DeMarco/DMH-Submodules/README.md

# DMH-Submodules
Collection of small plugin PCBs used as subcircuits in major Kosmo modules
