DeMarco/DMH-Submodules/DMH_Submodule_XFader/DMH_Submodule_XFader.kicad_pcb

## KiCad design DMH_Submodule_XFader/DMH_Submodule_XFader.kicad_pcb (2026-10-17)

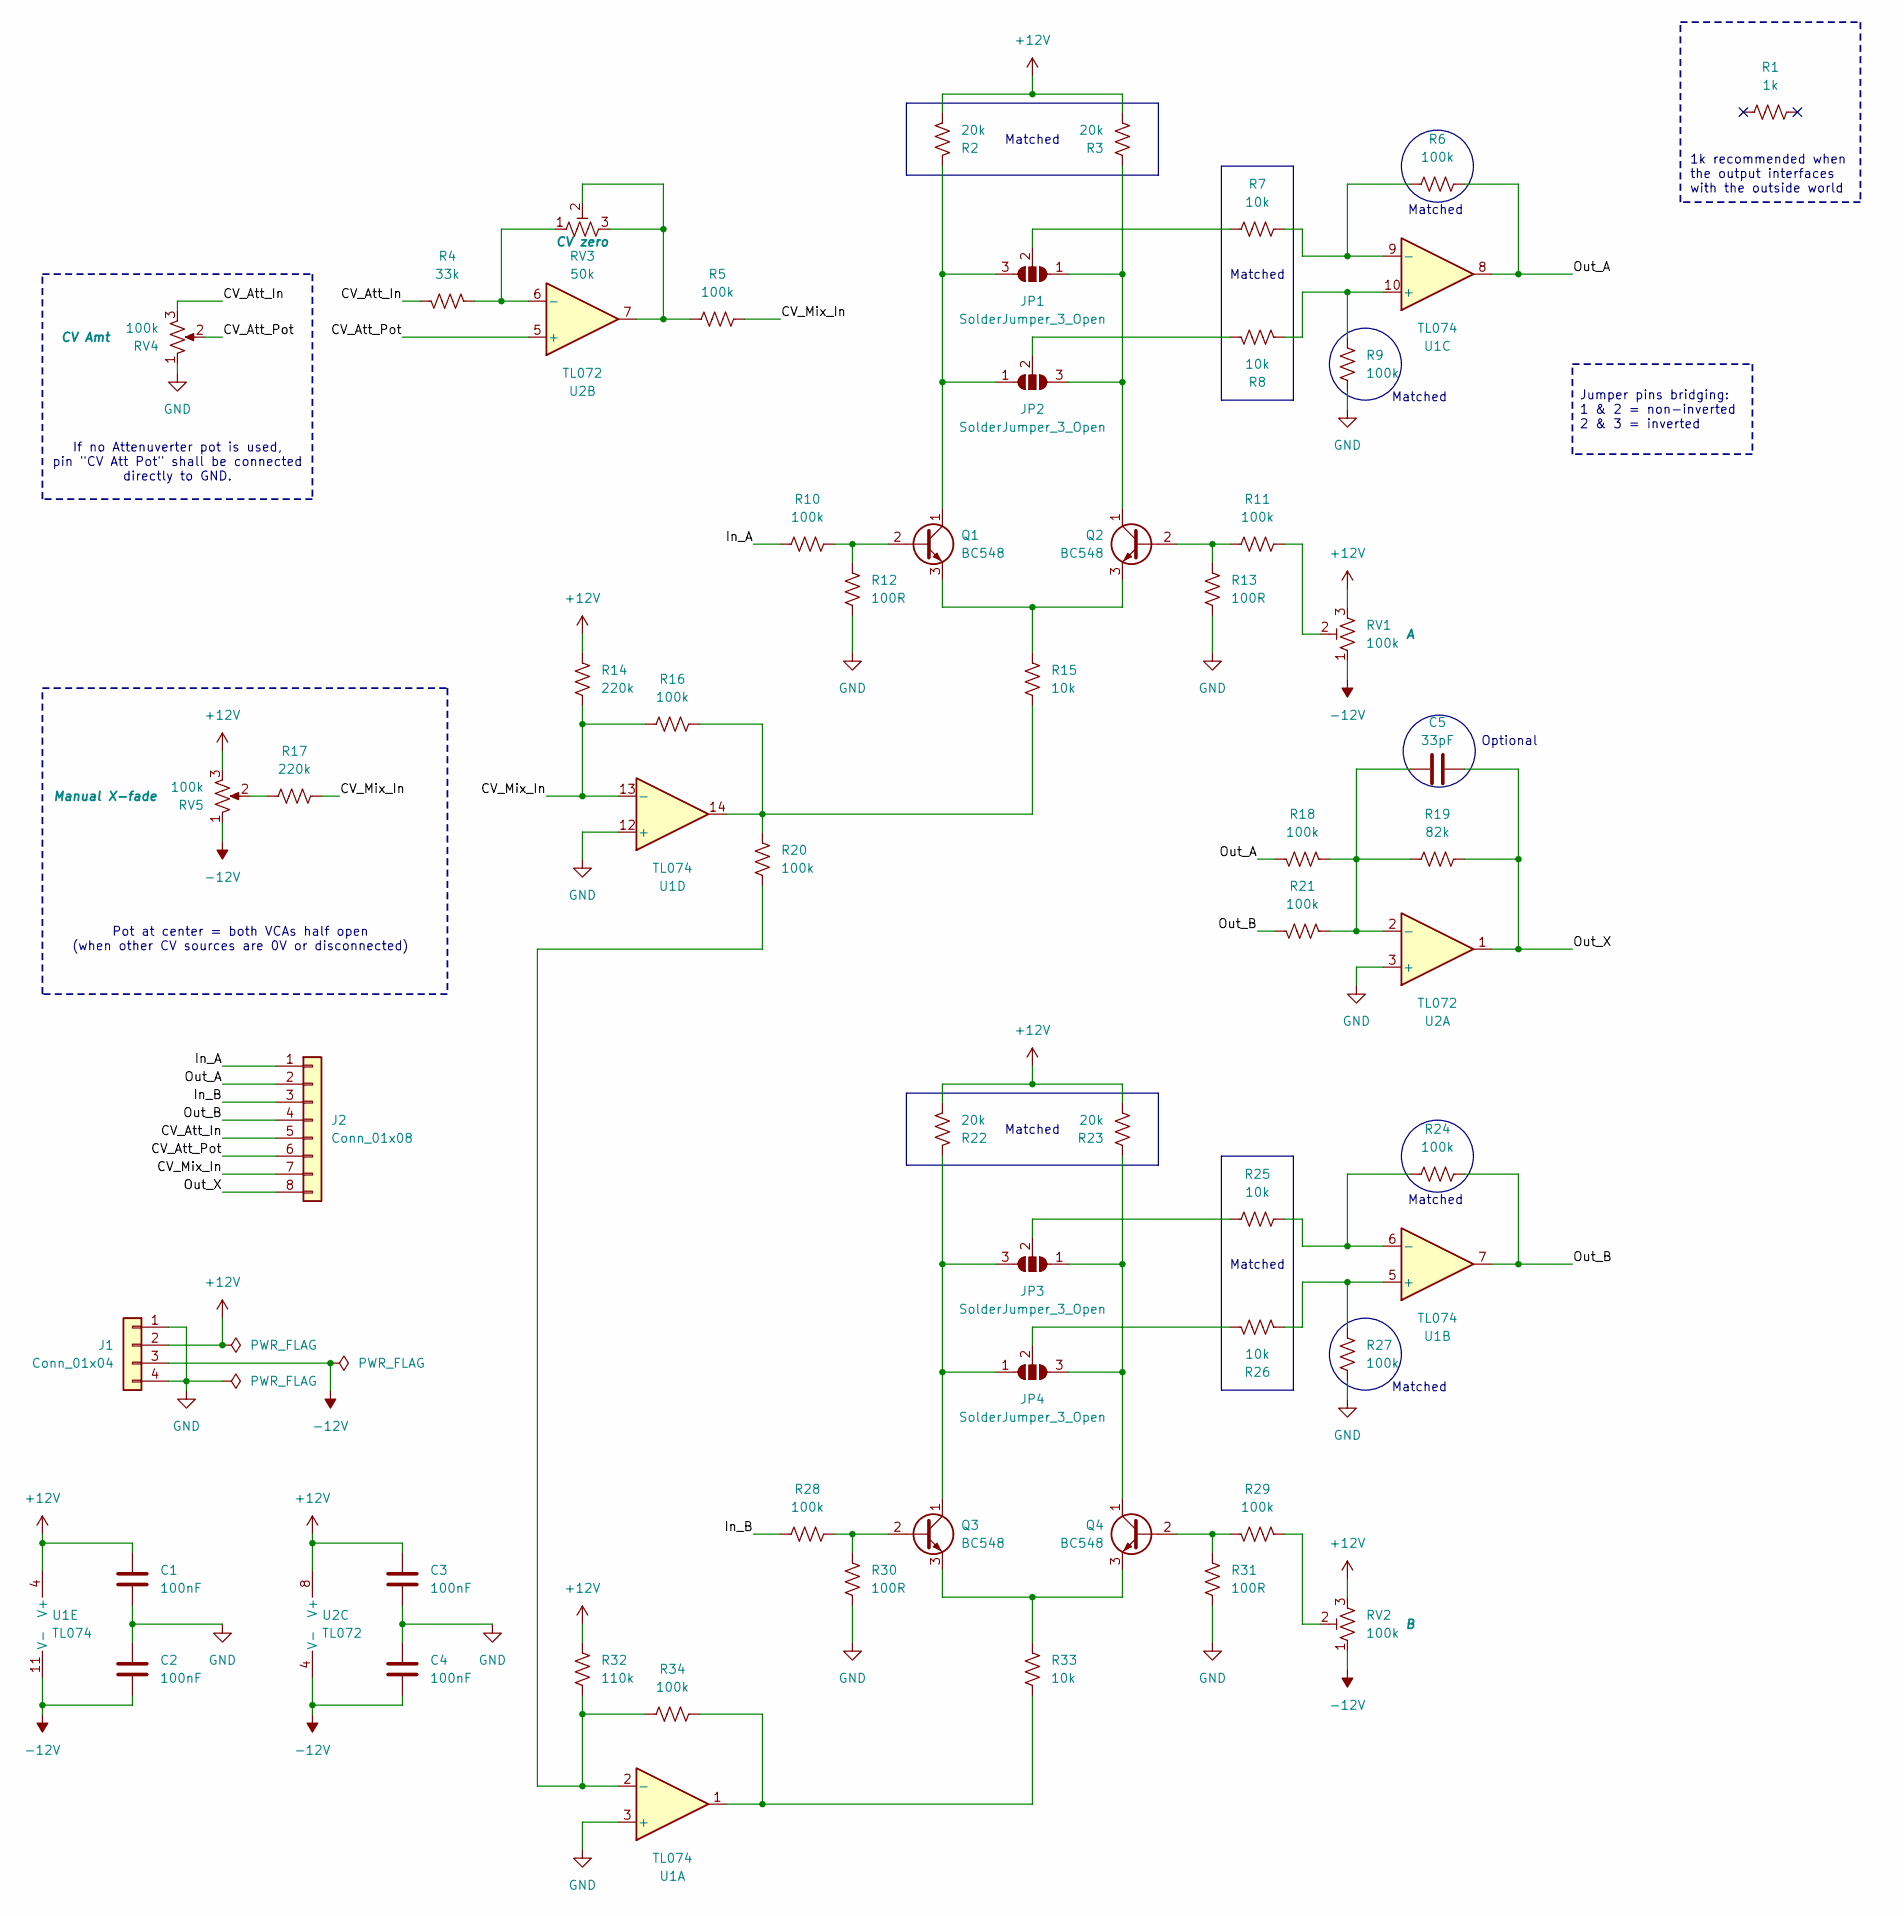
[picture p1: schematic DMH_Submodule_XFader.kicad_sch, Cross Fader Submodule]

Parts:
C1, C2, C3, C4: 100nF; C_Disc_D4.3mm_W1.9mm_P5.00mm
C5: 33pF; C_Disc_D3.0mm_W2.0mm_P2.50mm
J1: Conn_01x04; PinHeader_1x04_P2.54mm_Horizontal
J2: Conn_01x08; PinHeader_1x08_P2.54mm_Horizontal
JP1, JP2, JP3, JP4: SolderJumper_3_Open; SolderJumper-3_P1.3mm_Open_RoundedPad1.0x1.5mm_NumberLabels
Q1, Q2, Q3, Q4: BC548; TO-92L_Inline_Wide
R1: 1k; R_Axial_DIN0207_L6.3mm_D2.5mm_P7.62mm_Horizontal
R2, R3, R22, R23: 20k; R_Axial_DIN0207_L6.3mm_D2.5mm_P2.54mm_Vertical
R4: 33k; R_Axial_DIN0207_L6.3mm_D2.5mm_P2.54mm_Vertical
R5, R6, R9, R10, R11, R16, R18, R20, R21, R24, R27, R28, R29, R34: 100k; R_Axial_DIN0207_L6.3mm_D2.5mm_P2.54mm_Vertical
R7, R8, R15, R25, R26, R33: 10k; R_Axial_DIN0207_L6.3mm_D2.5mm_P2.54mm_Vertical
R12, R13, R30, R31: 100R; R_Axial_DIN0207_L6.3mm_D2.5mm_P2.54mm_Vertical
R14: 220k; R_Axial_DIN0207_L6.3mm_D2.5mm_P2.54mm_Vertical
R17: 220k; R_Axial_DIN0207_L6.3mm_D2.5mm_P7.62mm_Horizontal
R19: 82k; R_Axial_DIN0207_L6.3mm_D2.5mm_P2.54mm_Vertical
R32: 110k; R_Axial_DIN0207_L6.3mm_D2.5mm_P2.54mm_Vertical
RV1, RV2: 100k; Potentiometer_Bourns_3296X_Horizontal
RV3: 50k; Potentiometer_Bourns_3296X_Horizontal
RV4, RV5: 100k; Potentiometer_TT_P110KH1
U1: TL074; DIP-14_W7.62mm_Socket
U2: TL072; DIP-8_W7.62mm_Socket

Connections:
+12V: C1.1, C3.1, J1.2, R2.1, R3.1, R14.2, R22.1, R23.1, R32.2, RV1.3, RV2.3, RV5.3, U1.4 (V+), U2.8 (V+)
-12V: C2.2, C4.2, J1.3, RV1.1, RV2.1, RV5.1, U1.11 (V-), U2.4 (V-)
/CV_Att_In: J2.5, R4.2, RV4.3
/CV_Att_Pot: J2.6, RV4.2, U2.5 (+)
/CV_Mix_In: J2.7, R5.1, R14.1, R16.1, R17.2, U1.13 (-)
/In_A: J2.1, R10.2
/In_B: J2.3, R28.2
/Out_A: J2.2, R6.1, R18.2, U1.8
/Out_B: J2.4, R21.2, R24.1, U1.7
/Out_X: C5.2, J2.8, R19.2, U2.1
GND: C1.2, C2.1, C3.2, C4.1, J1.1, J1.4, R9.2, R12.1, R13.1, R27.2, R30.1, R31.1, RV4.1, U1.3 (+), U1.12 (+), U2.3 (+)
unnamed: JP1.1 (A), JP2.3 (B), Q2.1 (C), R3.2
unnamed: JP1.3 (B), JP2.1 (A), Q1.1 (C), R2.2
unnamed: JP1.2 (C), R7.2
unnamed: JP2.2 (C), R8.2
unnamed: JP3.1 (A), JP4.3 (B), Q4.1 (C), R23.2
unnamed: JP3.3 (B), JP4.1 (A), Q3.1 (C), R22.2
unnamed: JP3.2 (C), R25.2
unnamed: JP4.2 (C), R26.2
unnamed: Q1.2 (B), R10.1, R12.2
unnamed: Q1.3 (E), Q2.3 (E), R15.2
unnamed: Q2.2 (B), R11.2, R13.2
unnamed: Q3.2 (B), R28.1, R30.2
unnamed: Q3.3 (E), Q4.3 (E), R33.2
unnamed: Q4.2 (B), R29.1, R31.2
unnamed: R5.2, RV3.2, RV3.3, U2.7
unnamed: R11.1, RV1.2
unnamed: R15.1, R16.2, R20.2, U1.14
unnamed: R17.1, RV5.2
unnamed: R29.2, RV2.2
unnamed: R33.1, R34.2, U1.1
unnamed: R20.1, R32.1, R34.1, U1.2 (-)
unnamed: R26.1, R27.1, U1.5 (+)
unnamed: R24.2, R25.1, U1.6 (-)
unnamed: R8.1, R9.1, U1.10 (+)
unnamed: R6.2, R7.1, U1.9 (-)
unnamed: C5.1, R18.1, R19.1, R21.1, U2.2 (-)
unnamed: R4.1, RV3.1, U2.6 (-)

Notes on the sheet:
Matched
If no Attenuverter pot is used, pin "CV Att Pot" shall be connected directly to GND.
1k recommended when the output interfaces with the outside world
Pot at center = both VCAs half open (when other CV sources are 0V or disconnected)
Optional
Jumper pins bridging: 1 & 2 = non-inverted 2 & 3 = inverted

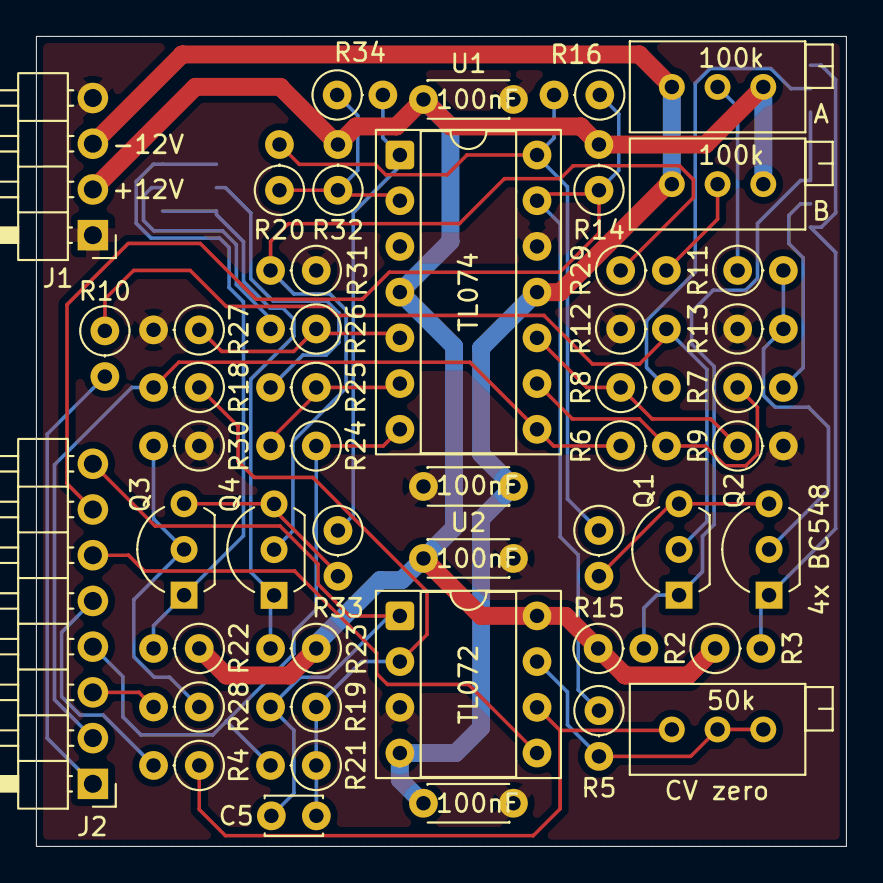
[picture p2: board DMH_Submodule_XFader.kicad_pcb from above]

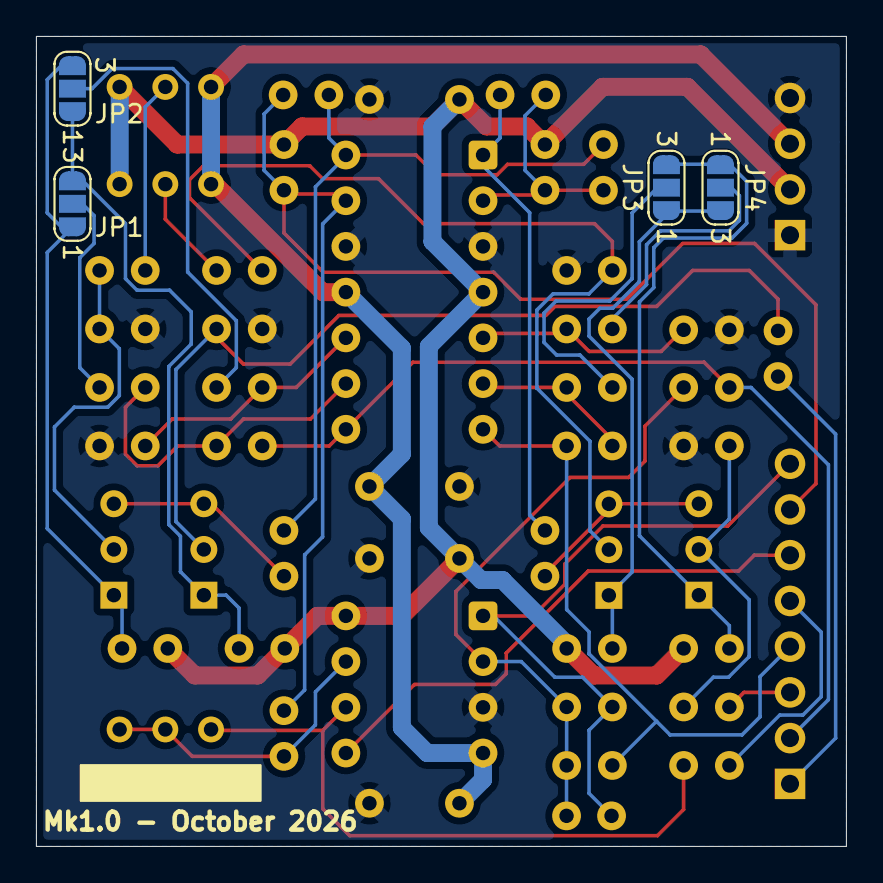
[picture p3: board DMH_Submodule_XFader.kicad_pcb from below]

Board: 2 copper layers, 45.0 x 45.0 mm, 52 parts (4 on the bottom side), 37 nets.
