DeMarco/DMH-Submodules/DMH_Submodule_VCA_Mk2/DMH_Submodule_VCA_Mk2.kicad_pcb

## KiCad design DMH_Submodule_VCA_Mk2/DMH_Submodule_VCA_Mk2.kicad_pcb (2026-10-07)

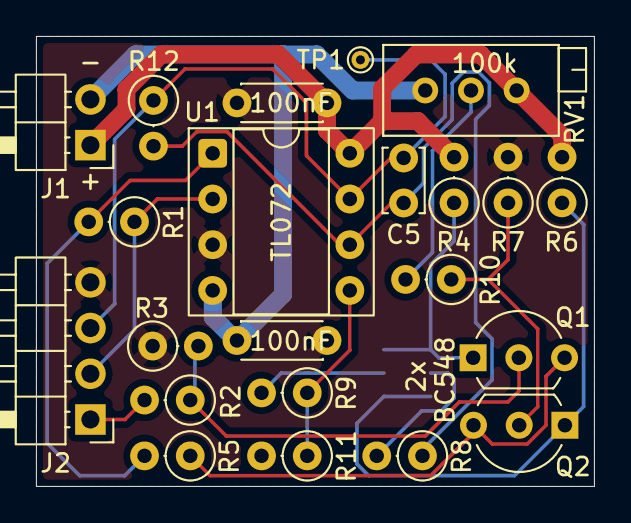
[picture p4: board DMH_Submodule_VCA_Mk2.kicad_pcb from above]

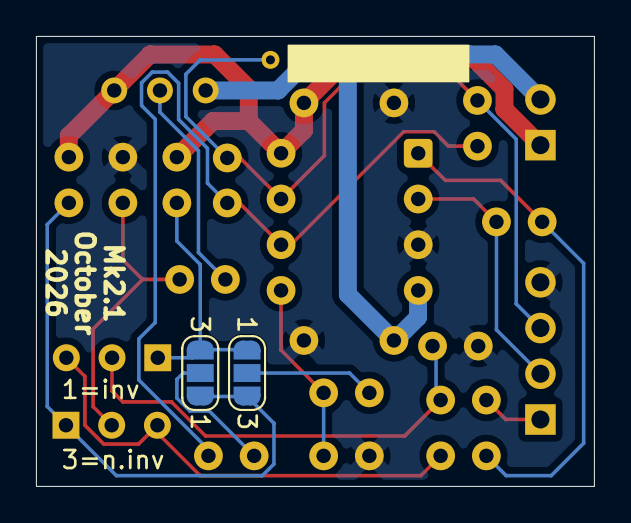
[picture p5: board DMH_Submodule_VCA_Mk2.kicad_pcb from below]

Board: 2 copper layers, 31.0 x 25.0 mm, 24 parts (2 on the bottom side), 17 nets.

Parts:
C1, C2: 100nF; C_Disc_D4.3mm_W1.9mm_P5.00mm
C5: 33pF; C_Disc_D3.4mm_W2.1mm_P2.50mm
J1: Conn_01x02; PinHeader_1x02_P2.54mm_Horizontal
J2: Conn_01x04; PinHeader_1x04_P2.54mm_Horizontal
JP1, JP2: SolderJumper_3_Open; SolderJumper-3_P1.3mm_Open_RoundedPad1.0x1.5mm_NumberLabels
Q1, Q2: BC548; TO-92L_Inline_Wide
R1, R2, R10, R11, R12: 100k; R_Axial_DIN0207_L6.3mm_D2.5mm_P2.54mm_Vertical
R3, R7: 100R; R_Axial_DIN0207_L6.3mm_D2.5mm_P2.54mm_Vertical
R4, R6: 20k; R_Axial_DIN0207_L6.3mm_D2.5mm_P2.54mm_Vertical
R5, R8, R9: 10k; R_Axial_DIN0207_L6.3mm_D2.5mm_P2.54mm_Vertical
RV1: 100k; Potentiometer_Bourns_3296X_Horizontal
TP1: TestPoint_Probe; TestPoint_THTPad_D1.0mm_Drill0.5mm
U1: TL072; DIP-8_W7.62mm_Socket

Connections:
+12V: C1.1, J1.1, R4.2, R6.2, RV1.3, U1.8 (V+)
-12V: C2.2, J1.2, RV1.1, U1.4 (V-)
/CV_Mix_In: J2.2, R1.1, U1.2 (-)
/Signal_In: J2.1, R2.2
/Signal_Out: C5.2, J2.3, R12.1, TP1.1 (1_1), U1.7
GND: C1.2, C2.1, J2.4, R3.1, R7.2, R11.2, U1.3 (+)
unnamed: JP1.1 (A), JP2.3 (B), Q2.1 (C), R6.1
unnamed: JP1.3 (B), JP2.1 (A), Q1.1 (C), R4.1
unnamed: JP1.2 (C), R8.2
unnamed: JP2.2 (C), R9.2
unnamed: Q1.2 (B), R2.1, R3.2
unnamed: Q1.3 (E), Q2.3 (E), R5.1
unnamed: Q2.2 (B), R7.1, R10.1
unnamed: R1.2, R5.2, U1.1
unnamed: R10.2, RV1.2
unnamed: R9.1, R11.1, U1.5 (+)
unnamed: C5.1, R8.1, R12.2, U1.6 (-)
