DeMarco/DMH-Submodules/DMH_Submodule_VCA/DMH_Submodule_VCA.kicad_pcb

## KiCad design DMH_Submodule_VCA/DMH_Submodule_VCA.kicad_pcb (2026-07-15, an earlier design)

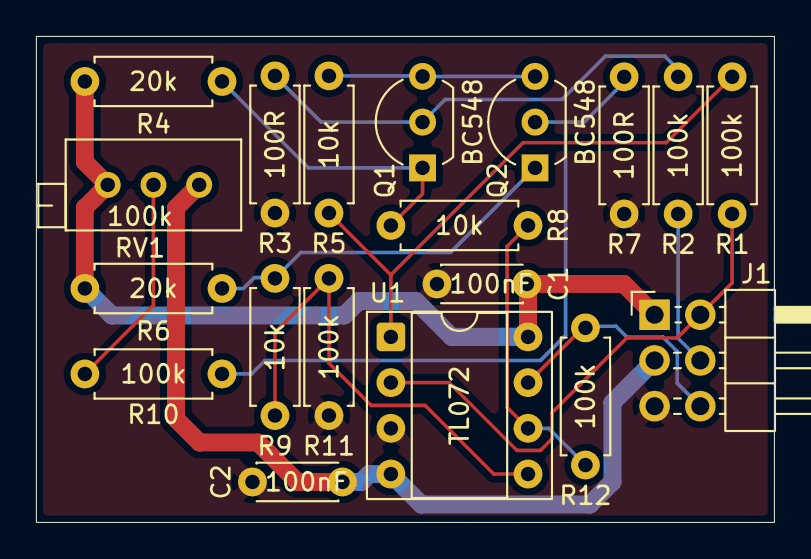
[picture p6: board DMH_Submodule_VCA.kicad_pcb from above]

Board: 2 copper layers, 41.0 x 27.0 mm, 19 parts (0 on the bottom side), 15 nets.

Parts:
C1, C2: 100nF; C_Disc_D4.3mm_W1.9mm_P5.00mm
J1: Conn_02x03_Odd_Even; PinHeader_2x03_P2.54mm_Horizontal
Q1, Q2: BC548; TO-92L_Inline_Wide
R1, R2, R10, R11, R12: 100k; R_Axial_DIN0207_L6.3mm_D2.5mm_P7.62mm_Horizontal
R3, R7: 100R; R_Axial_DIN0207_L6.3mm_D2.5mm_P7.62mm_Horizontal
R4, R6: 20k; R_Axial_DIN0207_L6.3mm_D2.5mm_P7.62mm_Horizontal
R5, R8, R9: 10k; R_Axial_DIN0207_L6.3mm_D2.5mm_P7.62mm_Horizontal
RV1: 100k; Potentiometer_Bourns_3296X_Horizontal
U1: TL072; DIP-8_W7.62mm_Socket

Connections:
+12V: C1.1, J1.1, R4.2, R6.2, RV1.3, U1.8 (V+)
-12V: C2.2, J1.3, RV1.1, U1.4 (V-)
/CV Mix In: J1.2, R1.1, U1.2 (-)
/Signal In: J1.4, R2.2
/Signal Out: J1.6, R12.1, U1.7
GND: C1.2, C2.1, J1.5, R3.1, R7.1, R11.2, U1.3 (+)
unnamed: Q1.2 (B), R2.1, R3.2
unnamed: Q1.1 (C), R4.1, R8.2
unnamed: Q1.3 (E), Q2.3 (E), R5.2
unnamed: Q2.2 (B), R7.2, R10.2
unnamed: Q2.1 (C), R6.1, R9.2
unnamed: R1.2, R5.1, U1.1
unnamed: R10.1, RV1.2
unnamed: R9.1, R11.1, U1.5 (+)
unnamed: R8.1, R12.2, U1.6 (-)
