DeMarco/DMH-Submodules/(commit log)

2026-03-23 VCA submodule PCB design in progress
    [Core_Circuit.kicad_sch, DMH_Submodule_VCA.kicad_pcb, DMH_Submodule_VCA.kicad_sch, Inputs_and_Outputs.kicad_sch, Power.kicad_sch]
2026-04-18 Designed PCB
    [Core_Circuit.kicad_sch, DMH_Submodule_VCA.kicad_pcb, DMH_Submodule_VCA.kicad_sch, Inputs_and_Outputs.kicad_sch, Power.kicad_sch]
2026-04-19 Derived VCA design blocks
    [DMH_Submodule_VCA.kicad_pcb, DMH_Submodule_VCA.kicad_sch]
2026-06-20 Generated VCA gerbers
    [DMH_Submodule_VCA-B_Cu.gbl, DMH_Submodule_VCA-B_Mask.gbs, DMH_Submodule_VCA-B_Paste.gbp, DMH_Submodule_VCA-B_Silkscreen.gbo, DMH_Submodule_VCA-Edge_Cuts.gm1, DMH_Submodule_VCA-F_Cu.gtl, DMH_Submodule_VCA-F_Mask.gts, DMH_Submodule_VCA-F_Paste.gtp]
2026-06-25 Corrected VCA gerber zip file name
2026-06-28 Started Xfader project and done simulation
    [DMH_Submodule_XFader.kicad_pcb, DMH_Submodule_XFader.kicad_sch]
2026-06-28 Designed X fader schematic
    [DMH_Submodule_XFader.kicad_sch]
2026-06-28 Xfader comp placement in progress
    [DMH_Submodule_XFader.kicad_pcb, DMH_Submodule_XFader.kicad_sch]
2026-07-01 Xfader comp placement done
    [DMH_Submodule_XFader.kicad_pcb, DMH_Submodule_XFader.kicad_sch]
2026-07-01 Xfader routing done
    [DMH_Submodule_XFader.kicad_pcb, DMH_Submodule_XFader.kicad_sch]
2026-07-01 Fixed Out A and B mix labels and routing
    [DMH_Submodule_XFader.kicad_pcb, DMH_Submodule_XFader.kicad_sch]
2026-07-14 Made connector breadboard compatible
    [DMH_Submodule_XFader-B_Cu.gbl, DMH_Submodule_XFader-B_Mask.gbs, DMH_Submodule_XFader-B_Paste.gbp, DMH_Submodule_XFader-B_Silkscreen.gbo, DMH_Submodule_XFader-Edge_Cuts.gm1, DMH_Submodule_XFader-F_Cu.gtl, DMH_Submodule_XFader-F_Mask.gts, DMH_Submodule_XFader-F_Paste.gtp]
2026-07-15 Swapped J1 and J2 tags around on XFader SM
    [DMH_Submodule_VCA.kicad_pcb, DMH_Submodule_VCA.kicad_sch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]
2026-07-15 Created VCA Submodule Mk2 project
    [DMH_Submodule_VCA_Mk2.kicad_pcb, DMH_Submodule_VCA_Mk2.kicad_sch]
2026-07-15 Routed VCA submodule Mk2 PCB
    [DMH_Submodule_VCA_Mk2-B_Cu.gbl, DMH_Submodule_VCA_Mk2-B_Mask.gbs, DMH_Submodule_VCA_Mk2-B_Paste.gbp, DMH_Submodule_VCA_Mk2-B_Silkscreen.gbo, DMH_Submodule_VCA_Mk2-Edge_Cuts.gm1, DMH_Submodule_VCA_Mk2-F_Cu.gtl, DMH_Submodule_VCA_Mk2-F_Mask.gts, DMH_Submodule_VCA_Mk2-F_Paste.gtp]
2026-10-06 Modified schematic
    [DMH_Submodule_VCA_Mk2.kicad_sch]
2026-10-07 Redesigned PCB
    Included solder bridge jumpers to selected between inverting and non-inverting mode. Added C5 for high freq stabilization.
    [DMH_Submodule_VCA_Mk2.kicad_pcb, DMH_Submodule_VCA_Mk2.kicad_sch]
2026-10-07 Updated SynthStuff design blocks with VCA Mk2
    [DMH_Submodule_VCA_Mk2.kicad_pcb, DMH_Submodule_VCA_Mk2.kicad_sch]
2026-10-17 Added solder jumpers to X faders
